mikeholscher/zmk-config-mikecinq/files/PG1316S--装配体.STEP

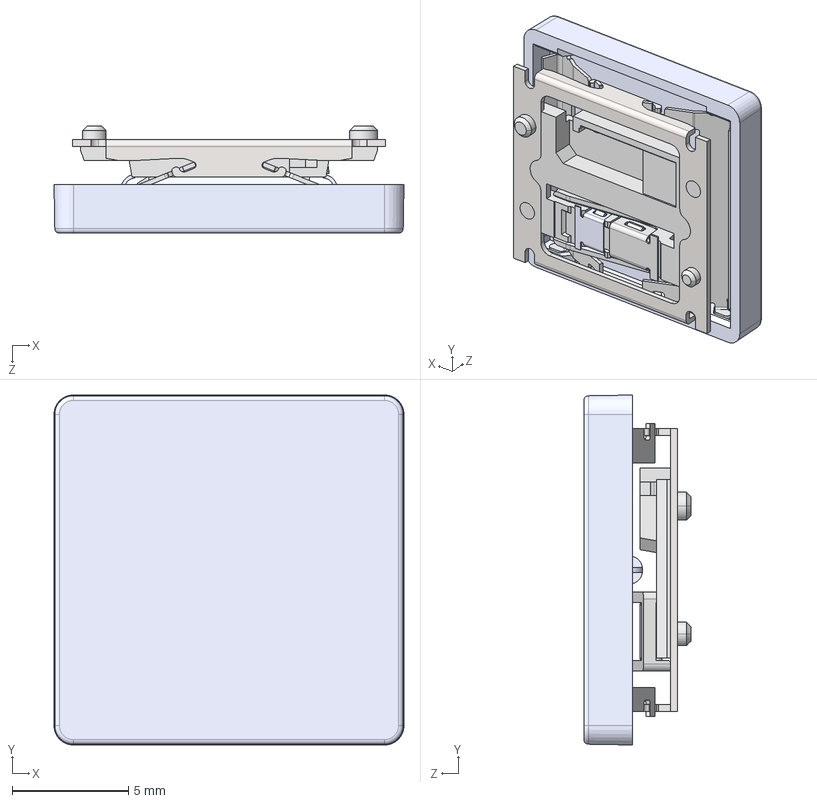
[picture p2: CAD file, 2025-07-17]
files/PG1316S--装配体.STEP
15.1 x 15.1 x 4.63 mm
1316S-基座卡件
PG1316S-價釱
驱动杆
す算殤
嶺銅
PG1316S-动接触片-带触点
PG1316S-静片-带触点
す算殤-B
瑩簽
