mikeholscher/zmk-config-mikecinq/files/mikecinq case.step

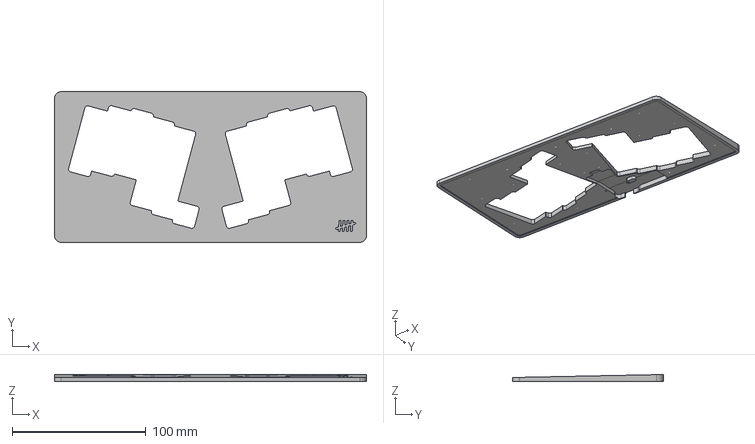
[picture p3: CAD file, 2025-07-17]
files/mikecinq case.step
232.9 x 112.5 x 5.22 mm
