mikeholscher/zmk-config-mikecinq/files/mikecinq case.pdf

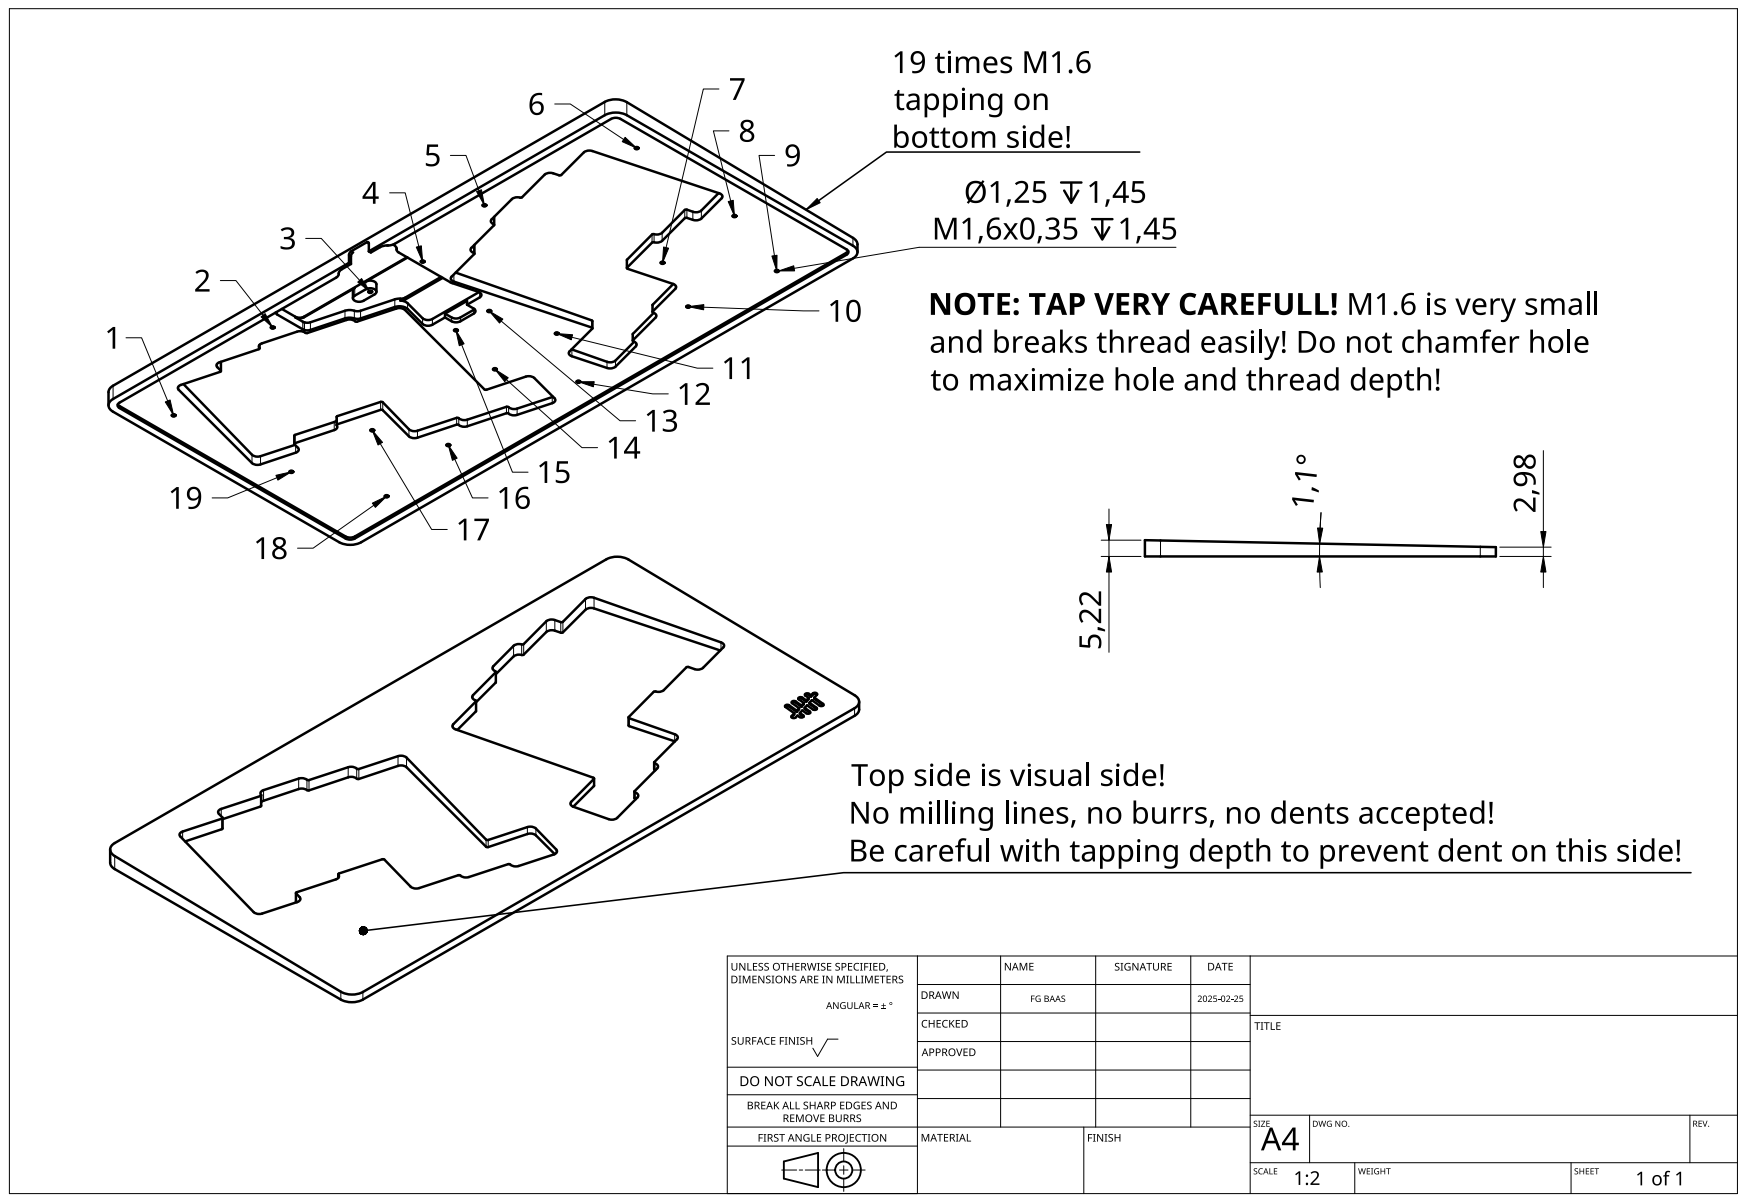
[picture p4: page 1]
