mikeholscher/zmk-config-mikecinq/files/mikecinq.kicad_pcb

## KiCad design files/mikecinq.kicad_pcb (2025-07-17)

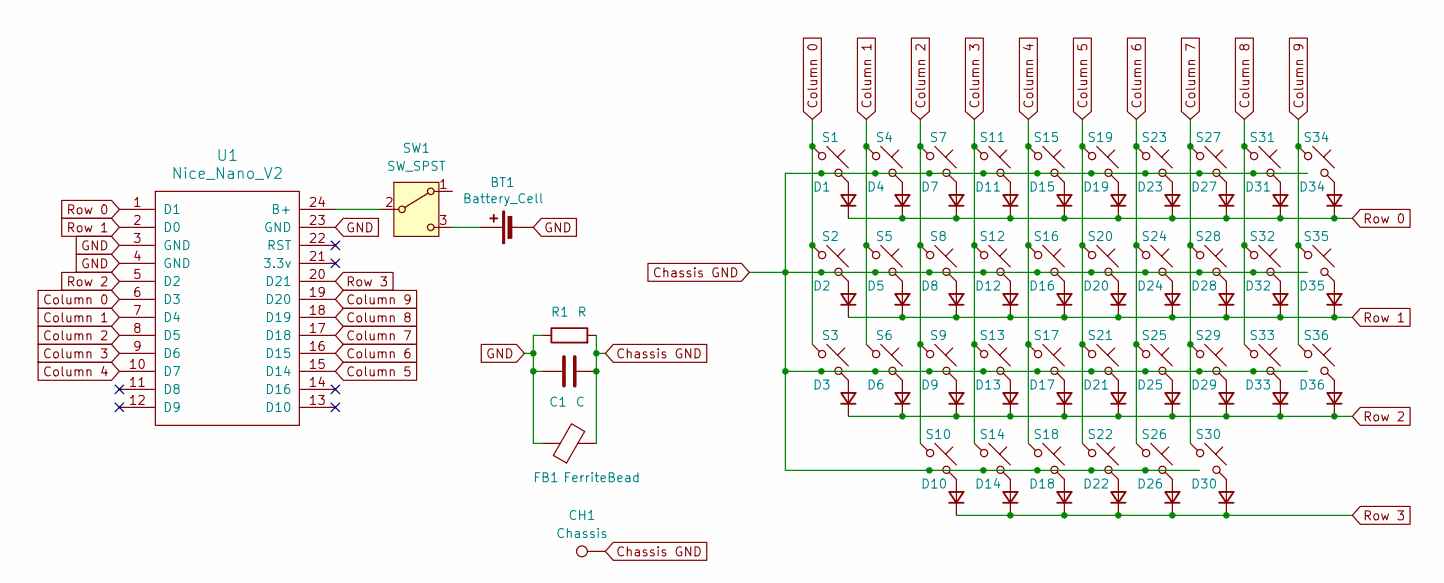
[picture p5: schematic mikecinq.kicad_sch]

Parts:
BT1: Battery_Cell; Battery_301230_Soldered
C1: C; C_0603_1608Metric
CH1: Chassis; Chassis GND
D1, D2, D3, D4, D5, D6, D7, D8, D9, D10, D11, D12, D13, D14, D15, D16, D17, D18, D19, D20, D21, D22, D23, D24, D25, D26, D27, D28, D29, D30, D31, D32, D33, D34, D35, D36: 1N4148WS; Diode_SOD-123; LCSC C2128
FB1: FerriteBead; L_0603_1608Metric
R1: R; R_0603_1608Metric
S1, S2, S3, S4, S5, S6, S7, S8, S9, S10, S11, S12, S13, S14, S15, S16, S17, S18, S19, S20, S21, S22, S23, S24, S25, S26, S27, S28, S29, S30, S31, S32, S33, S34, S35, S36: Keyswitch; CPG1316S01D02_handsolder
SW1: SW_SPST; MSK12C02
U1: Nice_Nano_V2; Nice_Nano_V2_Flat_Castelated

Connections:
Chassis GND: C1.2, CH1.1, FB1.2, R1.2, S1.3 (GND), S2.3 (GND), S3.3 (GND), S4.3 (GND), S5.3 (GND), S6.3 (GND), S7.3 (GND), S8.3 (GND), S9.3 (GND), S10.3 (GND), S11.3 (GND), S12.3 (GND), S13.3 (GND), S14.3 (GND), S15.3 (GND), S16.3 (GND), S17.3 (GND), S18.3 (GND), S19.3 (GND), S20.3 (GND), S21.3 (GND), S22.3 (GND), S23.3 (GND), S24.3 (GND), S25.3 (GND), S26.3 (GND), S27.3 (GND), S28.3 (GND), S29.3 (GND), S30.3 (GND), S31.3 (GND), S32.3 (GND), S33.3 (GND), S34.3 (GND), S35.3 (GND), S36.3 (GND)
Column 0: S1.1, S2.1, S3.1, U1.6 (D3)
Column 1: S4.1, S5.1, S6.1, U1.7 (D4)
Column 2: S7.1, S8.1, S9.1, S10.1, U1.8 (D5)
Column 3: S11.1, S12.1, S13.1, S14.1, U1.9 (D6)
Column 4: S15.1, S16.1, S17.1, S18.1, U1.10 (D7)
Column 5: S19.1, S20.1, S21.1, S22.1, U1.15 (D14)
Column 6: S23.1, S24.1, S25.1, S26.1, U1.16 (D15)
Column 7: S27.1, S28.1, S29.1, S30.1, U1.17 (D18)
Column 8: S31.1, S32.1, S33.1, U1.18 (D19)
Column 9: S34.1, S35.1, S36.1, U1.19 (D20)
GND: BT1.2 (-), C1.1, FB1.1, R1.1, U1.3 (GND), U1.4 (GND), U1.23 (GND)
unnamed: BT1.1 (+), SW1.3 (C)
unnamed: D1.2 (A), S1.2
unnamed: D2.2 (A), S2.2
unnamed: D3.2 (A), S3.2
unnamed: D4.2 (A), S4.2
unnamed: D5.2 (A), S5.2
unnamed: D6.2 (A), S6.2
unnamed: D7.2 (A), S7.2
unnamed: D8.2 (A), S8.2
unnamed: D9.2 (A), S9.2
unnamed: D10.2 (A), S10.2
unnamed: D11.2 (A), S11.2
unnamed: D12.2 (A), S12.2
unnamed: D13.2 (A), S13.2
unnamed: D14.2 (A), S14.2
unnamed: D15.2 (A), S15.2
unnamed: D16.2 (A), S16.2
unnamed: D17.2 (A), S17.2
unnamed: D18.2 (A), S18.2
unnamed: D19.2 (A), S19.2
unnamed: D20.2 (A), S20.2
unnamed: D21.2 (A), S21.2
unnamed: D22.2 (A), S22.2
unnamed: D23.2 (A), S23.2
unnamed: D24.2 (A), S24.2
unnamed: D25.2 (A), S25.2
unnamed: D26.2 (A), S26.2
unnamed: D27.2 (A), S27.2
unnamed: D28.2 (A), S28.2
unnamed: D29.2 (A), S29.2
unnamed: D30.2 (A), S30.2
unnamed: D31.2 (A), S31.2
unnamed: D32.2 (A), S32.2
unnamed: D33.2 (A), S33.2
unnamed: D34.2 (A), S34.2
unnamed: D35.2 (A), S35.2
unnamed: D36.2 (A), S36.2
unnamed: SW1.2 (B), U1.24 (B+)
Row 0: D1.1 (K), D4.1 (K), D7.1 (K), D11.1 (K), D15.1 (K), D19.1 (K), D23.1 (K), D27.1 (K), D31.1 (K), D34.1 (K), U1.1 (D1)
Row 1: D2.1 (K), D5.1 (K), D8.1 (K), D12.1 (K), D16.1 (K), D20.1 (K), D24.1 (K), D28.1 (K), D32.1 (K), D35.1 (K), U1.2 (D0)
Row 2: D3.1 (K), D6.1 (K), D9.1 (K), D13.1 (K), D17.1 (K), D21.1 (K), D25.1 (K), D29.1 (K), D33.1 (K), D36.1 (K), U1.5 (D2)
Row 3: D10.1 (K), D14.1 (K), D18.1 (K), D22.1 (K), D26.1 (K), D30.1 (K), U1.20 (D21)

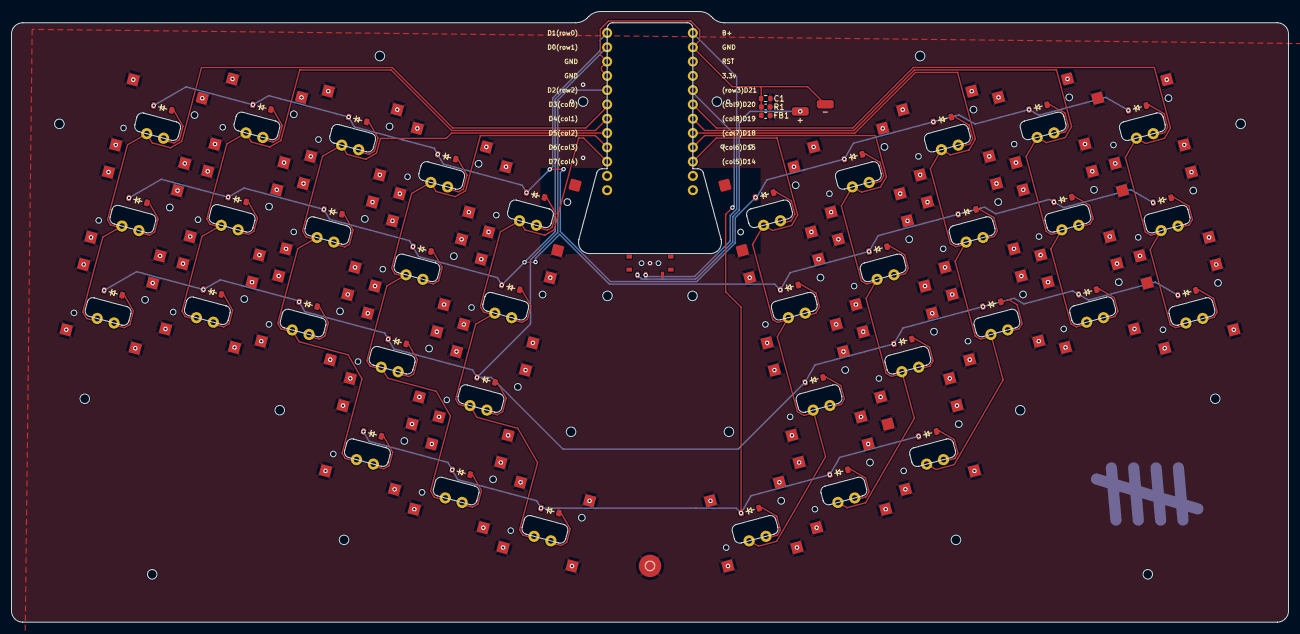
[picture p6: board mikecinq.kicad_pcb from above]

Board: 2 copper layers, 226.9 x 108.5 mm, 79 parts (0 on the bottom side), 54 nets.
