mikeholscher/zmk-config-mikecinq/(notices)

Notices in the files:
readme.md:
CC BY-NC-SA 4.0
